duvohuu/Spider_Robot/latex/report/titlepage.tex

\begin{titlepage}   
    \begin{center}
        \vspace*{-2cm} 
        \large
        \textbf{ĐẠI HỌC QUỐC GIA THÀNH PHỐ HỒ CHÍ MINH \\
        TRƯỜNG ĐẠI HỌC BÁCH KHOA\\
        KHOA CƠ KHÍ \\}
        \vspace{0.5cm}
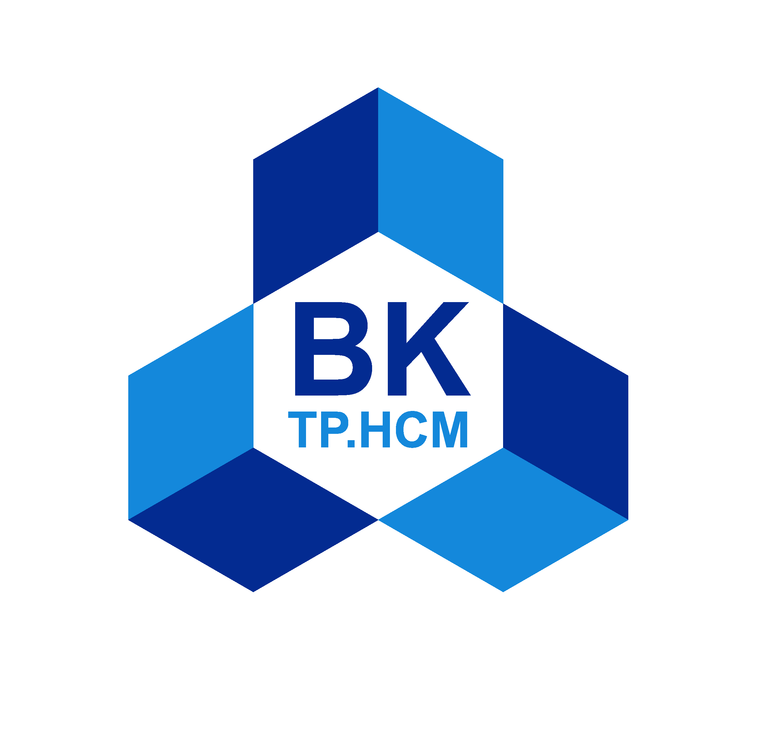
[picture p1: latex/report/pictures/hcmut.png]
         \\
        \rule{\linewidth}{0.5mm}\\
        \vspace{0.5cm}
        \Large
        \textbf{ĐỒ ÁN MÔN HỌC}\\                                                                                                                                                                                                                                                                                                                                                                                                                                                                                                                                                                                                                                                         
        \vspace{0.5cm}
        \textbf{THIẾT KẾ HỆ THỐNG CƠ ĐIỆN TỬ}\\
        \vspace{0.5cm}
        \LARGE
        \textbf{ĐỀ TÀI: THIẾT KẾ ROBOT 6 CHÂN DẠNG NHỆN} \\
        \rule{\linewidth}{0.5mm}\\
        \vspace{0.5cm}
        \large
        \textbf{LỚP L01 - HK 252} \\
        \vspace{0.5cm}
        \textbf{GVHD: Ths. Nguyễn Minh Tuấn} \\
        \begin{table}[H]
            \centering
            \large
            \textbf{Danh sách thành viên nhóm:}\\
            \vspace{0.5cm}
            \begin{tabular}{|c|c|c|}
                \hline
                \textbf{STT} & \textbf{Họ và Tên} & \textbf{MSSV} \\
                \hline
                1 & Võ Hữu Dư & 2210604\\
                \hline
                2 & Trần Quang Đạo & 2210647\\
                \hline
                3 & Nguyễn Việt Chương & 2210398\\
                \hline
                4 & Nguyễn Hoàng Thái Khang & 2211448\\
                \hline
            \end{tabular}
        \end{table}
    \end{center}        
    \vfill
    \large
    \begin{center}
        \today
    \end{center}
\end{titlepage}
