duvohuu/Spider_Robot/latex/report/main.tex

\documentclass[12pt,a4paper]{report}
\input{library}
\addbibresource{references.bib} 

%Header
\fancyhead{} % clear all header fields
\fancyhead[L]{
 \begin{tabular}{rl}
    \begin{picture}(15, 15)(0,0)
        \put(-15, -15){}
    \end{picture}&
	%\includegraphics[width=8mm, height=8mm]{hcmut.png} & %
	\begin{tabular}{l}
		\textbf{\normalsize \ttfamily Trường Đại Học Bách Khoa - ĐHQG TP.HCM}\\
		\textbf{\normalsize \ttfamily Khoa Cơ Khí}
	\end{tabular} 	
 \end{tabular}
}
\fancyhead[R]{CHƯƠNG \thechapter}

%Footer
\fancyfoot{} % clear all footer fields
\fancyfoot[L]{\normalsize \ttfamily Thiết kế hệ thống cơ điện tử}
\fancyfoot[R]{\normalsize \ttfamily Trang {\thepage}/65}
\renewcommand{\headrulewidth}{0.3pt}
\renewcommand{\footrulewidth}{0.3pt}

\begin{document}
    \include{titlepage}
    \section*{\centering LỜI CẢM ƠN}
        \hspace{0.5cm} Chúng tôi xin gửi lời cảm ơn chân thành nhất đến tất cả những người đã đóng góp và hỗ trợ trong quá trình thực hiện bài tập lớn này..\\

        Đầu tiên và quan trọng nhất, chúng tôi muốn bày tỏ lòng biết ơn sâu sắc đến PGS.TS. Nguyễn Đình Huy về sự hỗ trợ và sự hướng dẫn không ngừng nghỉ của họ. Sự kiên nhẫn, sự chia sẻ kiến thức của thầy đã là nguồn động viên lớn lao giúp chúng tôi vượt qua những thách thức trong quá trình này.\\

        Chúng tôi cũng muốn bày tỏ lòng biết ơn đến các thành viên trong nhóm cũng như bạn bè về sự hợp tác và cống hiến của họ. Sự đoàn kết và sự cống hiến từ mỗi thành viên đã góp phần tạo ra một dự án hoàn chỉnh và chất lượng.\\

        Cuối cùng, chúng tôi muốn gửi lời cảm ơn chân thành nhất đến tất cả những người sẽ lắng nghe và đánh giá bài báo cáo của chúng tôi. Sự quan tâm và hỗ trợ từ bạn đã là động lực mạnh mẽ để chúng tôi hoàn thiện công việc của mình.\\
        
        Một lần nữa, chân thành cảm ơn sâu sắc từ chúng tôi đến tất cả những người đã đóng góp vào dự án này. Sự hỗ trợ và lòng tận tụy của mọi người đã làm cho dự án này trở thành hiện thực.\\
    \tableofcontents
    \listoftables
    \listoffigures
    \newpage
    \normalsize
    \include{chapter1}
    \include{chapter2}
    \include{chapter3}
    \include{chapter4}
    \include{chapter5}
    \include{chapter6}
    \include{chapter7}
    \nocite{*}
    \printbibliography[title={TÀI LIỆU THAM KHẢO}, heading=bibintoc]
\end{document}
