duvohuu/Spider_Robot/latex/slides/chapter1.tex

% ============================================================
% CHƯƠNG 1: NHẬN BIẾT NHU CẦU
% ============================================================
\section{Nhận Biết Nhu Cầu}

% ---- Slide 1.1: Bối cảnh + Nhu cầu ----
\begin{frame}{Bối Cảnh Và Nhu Cầu Thực Tiễn}
  \begin{columns}[T]
    \column{0.52\textwidth}
      \textbf{Robot di động truyền thống:}
      \begin{itemize}
        \item Bánh xe / dải xích -- hạn chế trên địa hình gồ ghề
        \item Kém linh hoạt trong không gian chật hẹp
      \end{itemize}
      \vspace{0.2cm}
      \textbf{Nhu cầu thực tiễn cần đáp ứng:}
      \begin{itemize}
        \item \textbf{Đa địa hình:} Mỗi chân điều chỉnh độc lập
        \item \textbf{Ổn định:} Tripod gait -- luôn $\geq 3$ chân tiếp đất
        \item \textbf{Realtime:} IK + đồng bộ 18 servo
        \item \textbf{Chi phí:} Servo MG996R, ESP32, in 3D
        \item \textbf{Giáo dục:} Nền tảng nghiên cứu cơ điện tử
      \end{itemize}
    \column{0.45\textwidth}
      \centering
      
      \\\small\textit{Robot nhện 6 chân của nhóm}
  \end{columns}
\end{frame}

% ---- Slide 1.3: Lý do chọn đề tài ----
\begin{frame}{Lý Do Chọn Đề Tài}
  \begin{block}{\centering Thiết kế và chế tạo robot nhện 6 chân}
    \centering Đề tài tích hợp điển hình của ngành Cơ Điện Tử
  \end{block}
  \vspace{0.2cm}
  \begin{columns}[T]
    \column{0.48\textwidth}
      \begin{exampleblock}{Tính hội tụ kiến thức}
        Cơ khí $+$ Điện tử $+$ Lập trình nhúng $+$ Truyền thông không dây
      \end{exampleblock}
      \vspace{0.15cm}
      \begin{exampleblock}{Tính thực tiễn cao}
        Quân sự, cứu nạn, kiểm tra đường ống, thám hiểm không gian
      \end{exampleblock}
    \column{0.48\textwidth}
      \begin{exampleblock}{Khả năng thực thi}
        Máy in 3D, linh kiện phổ biến -- hoàn thành trong 1 học kỳ
      \end{exampleblock}
      \vspace{0.15cm}
      \begin{exampleblock}{Giá trị học thuật}
        Tối ưu cấu hình chân, thuật toán dáng đi, mạch điều khiển phân tán
      \end{exampleblock}
  \end{columns}
\end{frame}
