duvohuu/Spider_Robot/latex/slides/chapter6.tex

% ============================================================
% CHƯƠNG 6: THIẾT KẾ CHI TIẾT
% ============================================================
\section{Thiết Kế Chi Tiết}

% ---- Slide 6.1: Chi tiết cơ khí ----
\begin{frame}{Thiết Kế Chi Tiết Cơ Khí}
  \begin{columns}[T]
    \column{0.22\textwidth}
      \centering
      
      \\\small\textit{Thân robot}
    \column{0.22\textwidth}
      \centering
      
      \\\small\textit{Khớp Coxa}
    \column{0.22\textwidth}
      \centering
      
      \\\small\textit{Khớp Femur}
    \column{0.22\textwidth}
      \centering
      
      \\\small\textit{Khớp Tibia}
  \end{columns}
  \vspace{0.3cm}
  \begin{columns}[T]
    \column{0.48\textwidth}
      \textbf{Thông số chân:} L1--L2--L3 = 168--120--60 mm
    \column{0.48\textwidth}
      \textbf{Vật liệu:} Nhựa PLA in 3D FDM
  \end{columns}
\end{frame}

% ---- Slide 6.2: Tính toán lựa chọn servo ----
\begin{frame}{Tính Toán Lựa Chọn Servo}
  \begin{columns}[T]
    \column{0.48\textwidth}
      \centering
      
      \\\small\textit{Mô hình tải trọng -- 3 chân tiếp đất}
    \column{0.50\textwidth}
      \small
      \textbf{Phản lực (3 chân đỡ):}
      $N_3 = W/3 = 19.62/3 \approx 6.54\;\text{N}$

      \vspace{0.15cm}
      \textbf{Mômen khớp Femur (lớn nhất):}
      $T_h = N_3 (L_1{+}L_2{+}L_3) \approx 23.2\;\text{kgf.cm}$

      \vspace{0.15cm}
      \textbf{Mômen yêu cầu ($K{=}1.3$):}
      $T_\text{cần} = 1.3 \times 23.2 \approx 30.2\;\text{kgf.cm}$

      \vspace{0.15cm}
      \begin{alertblock}{Chọn Servo DS3218}
        \small Moment max $\approx 20$--25 kgf.cm tại 6V\\
        Kết hợp bố trí cơ khí tối ưu
      \end{alertblock}
  \end{columns}
\end{frame}

% ---- Slide 6.3: ANSYS kết quả ----
\begin{frame}{Phân Tích Lực ANSYS -- Kết Quả}
  \begin{columns}[T]
    \column{0.32\textwidth}
      \centering
      
      \\\small\textit{\textbf{Ứng suất} von Mises}
    \column{0.32\textwidth}
      \centering
      
      \\\small\textit{\textbf{Chuyển vị} -- max 2.38 mm}
    \column{0.32\textwidth}
      \centering
      
      \\\small\textit{\textbf{Biến dạng} -- $\varepsilon_\mathrm{max}=3.19{\times}10^{-3}$}
  \end{columns}
\end{frame}

% ---- Slide 6.4: Mạch điện PCB ----
\begin{frame}{Thiết Kế Chi Tiết Mạch Điện}
  \begin{columns}[T]
    \column{0.48\textwidth}
      \centering
      
      \\\small\textit{Layout mạch PCB}
      \begin{itemize}\small
        \item ESP32 + 2 $\times$ PCA9685
        \item Kết nối 18 servo
      \end{itemize}
    \column{0.48\textwidth}
      \centering
      
      \\\small\textit{Mô hình PCB 3D}
      \begin{itemize}\small
        \item Cầu chì bảo vệ nguồn
        \item DC-DC tách nguồn servo / điều khiển
      \end{itemize}
  \end{columns}
\end{frame}
