duvohuu/Spider_Robot/latex/report/pictures/ElectricalDiagram.pdf

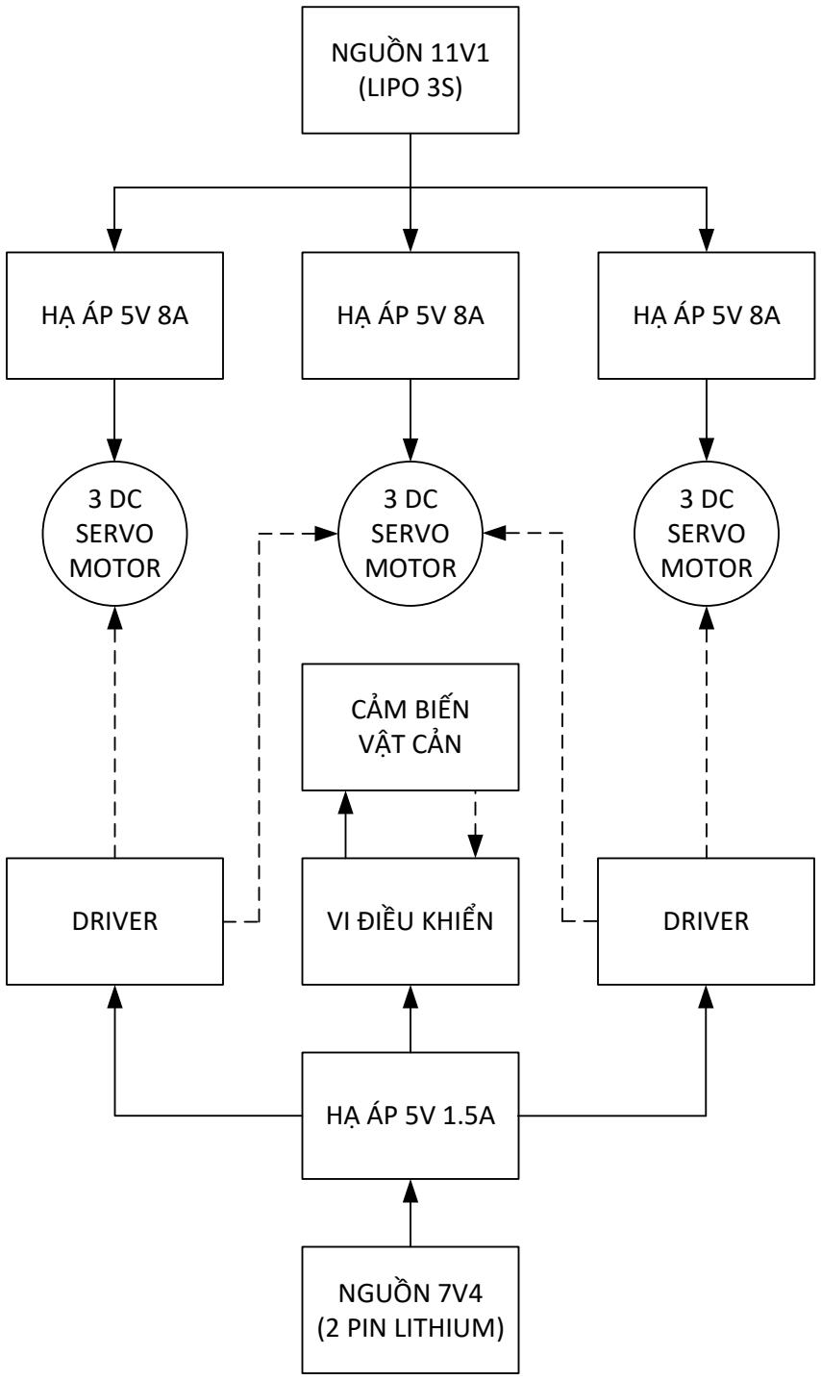
[picture p36: figure]
NGUỒN 11V1 (LIPO 3S); 3 DC SERVO MOTOR; NGUỒN 7V4 (2 PIN LITHIUM); DRIVER; VI ĐIỀU KHIỂN; CẢM BIẾN VẬT CẢN
