duvohuu/Spider_Robot/latex/slides/main.tex

\documentclass[aspectratio=169]{beamer}

% ============================================================
% Preamble: packages, theme, màu sắc, font, footer
% ============================================================
\input{library}

% ============================================================
% Thông tin bài thuyết trình
% ============================================================
\title[Robot 6 Chân Dạng Nhện]{Thiết kế Robot 6 Chân Dạng Nhện}
\subtitle{Thiết Kế Hệ Thống Cơ Điện Tử}
\author[Nhóm 05]{
  Võ Hữu Dư (2210604) \and
  Trần Quang Đạo (2210647) \and
  Nguyễn Việt Chương (2412192) \and
  Nguyễn Hoàng Thái Khang (2411202)
}
\institute[HCMUT]{
  Trường Đại Học Bách Khoa -- ĐHQG TP.HCM \\
  Khoa Cơ Khí -- Lớp L01 -- HK252
}
\date{\today}

% ============================================================
% NỘI DUNG
% ============================================================
\begin{document}

\include{titlepage}

\include{chapter1}
\include{chapter2}
\include{chapter3}
\include{chapter4}
\include{chapter5}
\include{chapter6}
\include{chapter7}

\end{document}
