duvohuu/Spider_Robot/hardware/PCB.kicad_pcb

## KiCad design hardware/PCB.kicad_pcb (2026-05-05)

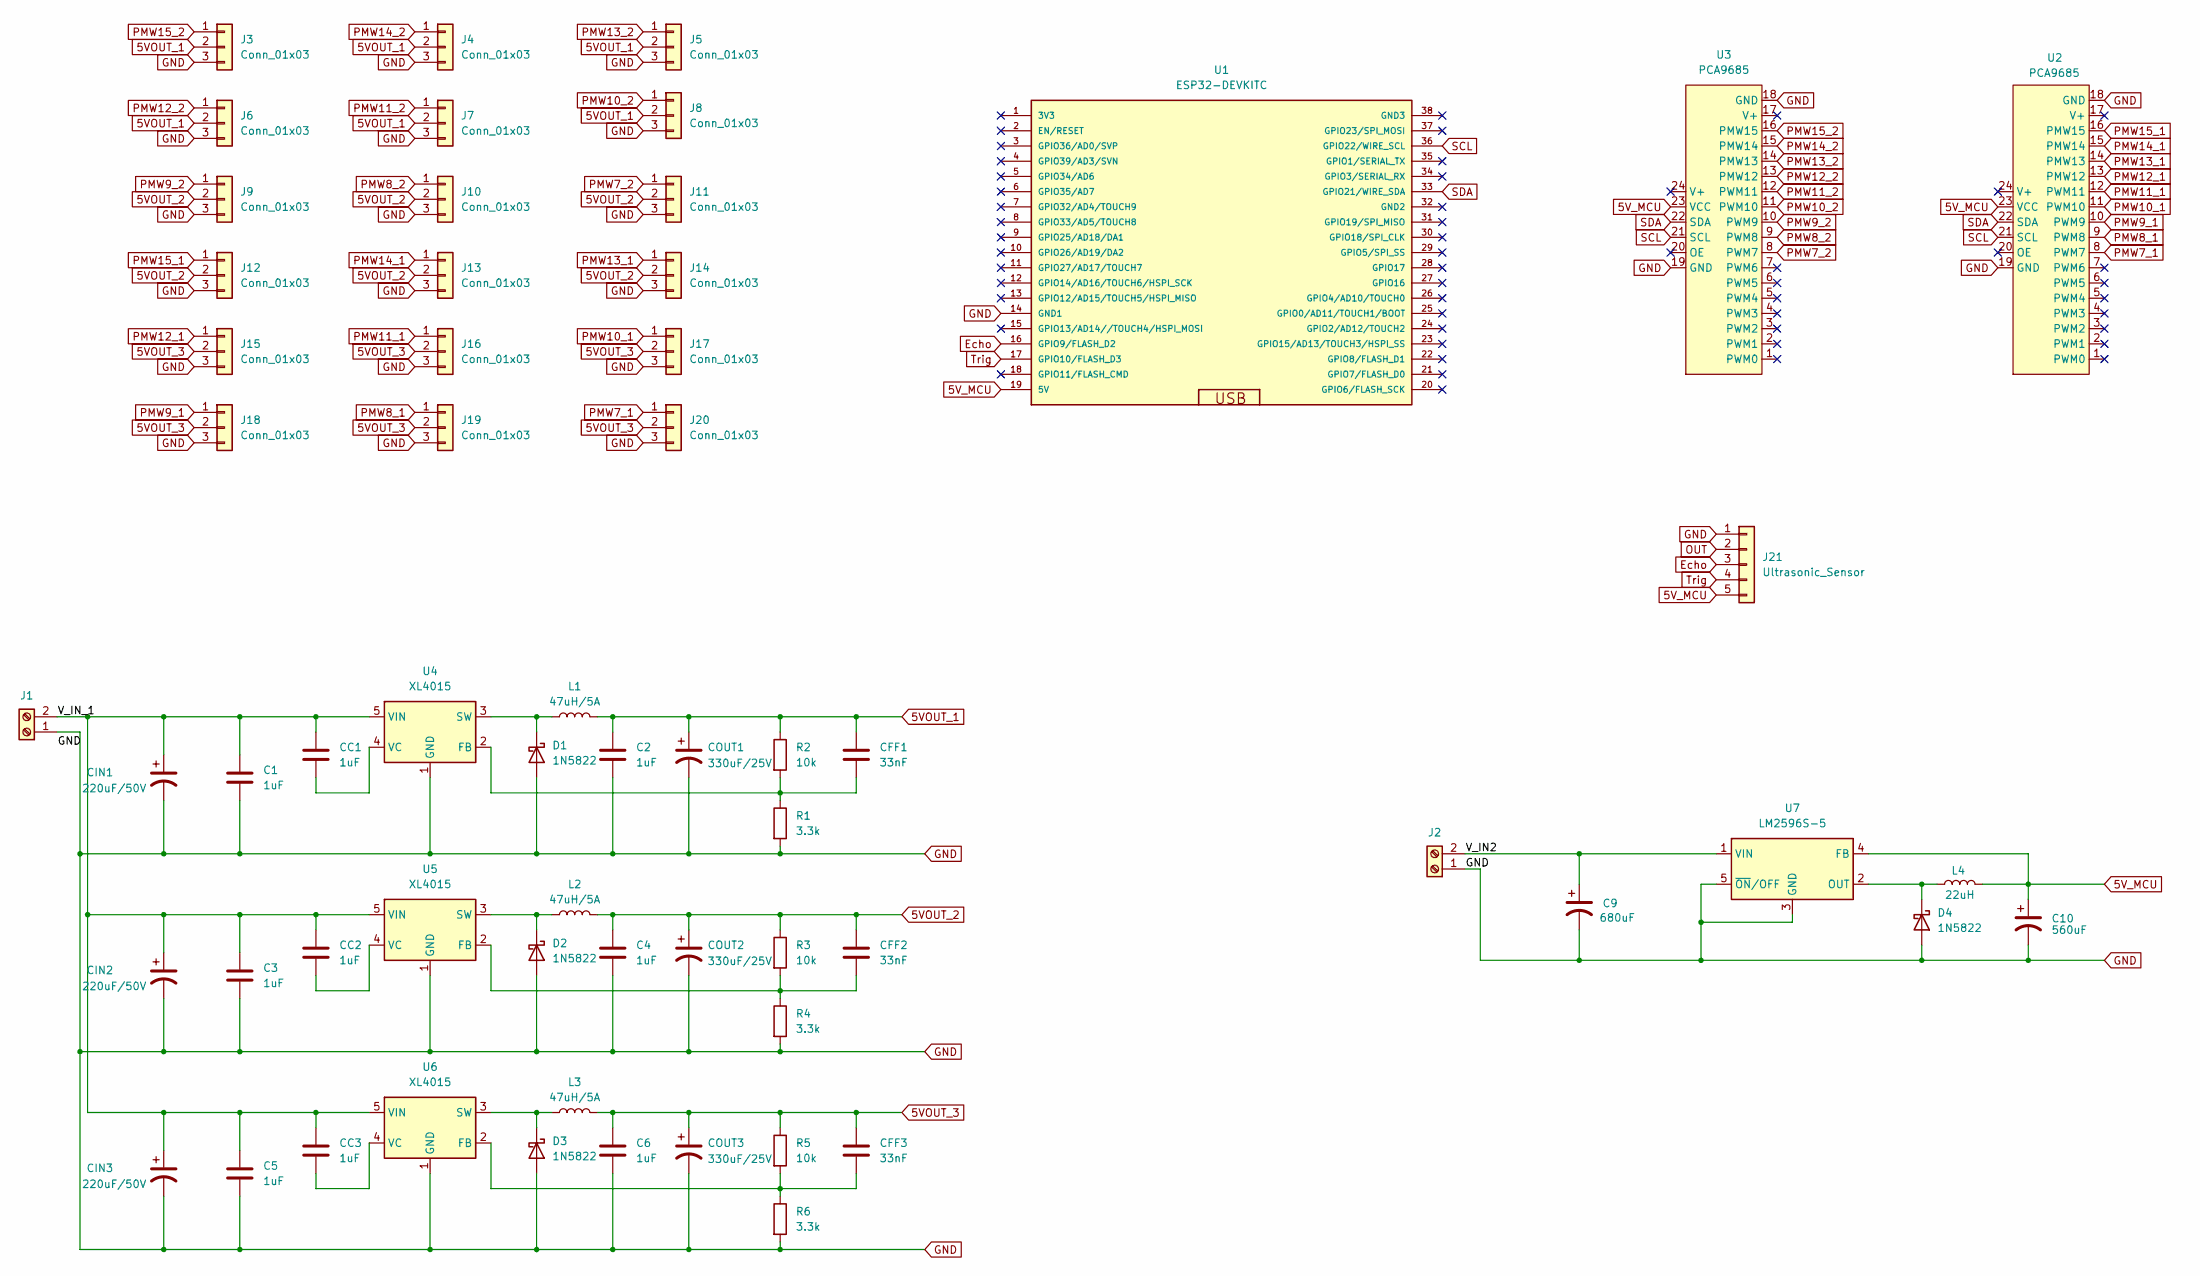
[picture p42: schematic PCB.kicad_sch]

Parts:
C1, C2, C3, C4, C5, C6: 1uF; C_0603_1608Metric_Pad1.08x0.95mm_HandSolder
C9: 680uF; CP_Radial_D8.0mm_P5.00mm
C10: 560uF; CP_Radial_D8.0mm_P5.00mm
CC1, CC2, CC3: 1uF; C_0603_1608Metric_Pad1.08x0.95mm_HandSolder
CFF1, CFF2, CFF3: 33nF; C_0603_1608Metric_Pad1.08x0.95mm_HandSolder
CIN1, CIN2, CIN3: 220uF/50V; CP_Radial_D8.0mm_P5.00mm
COUT1, COUT2, COUT3: 330uF/25V; CP_Radial_D8.0mm_P5.00mm
D1, D2, D3, D4: 1N5822; D_SMA_Handsoldering
J1, J2: MCU POWER; TerminalBlock_MaiXu_MX126-5.0-02P_1x02_P5.00mm
J3, J4, J5, J6, J7, J8, J9, J10, J11, J12, J13, J14, J15, J16, J17, J18, J19, J20: Conn_01x03; PinHeader_1x03_P2.54mm_Vertical
J21: Ultrasonic_Sensor; PinHeader_1x05_P2.54mm_Vertical
L1, L2, L3: 47uH/5A; L_12x12mm_H8mm
L4: 22uH; L_12x12mm_H8mm
R1, R4, R6: 3.3k; R_Axial_DIN0207_L6.3mm_D2.5mm_P7.62mm_Horizontal
R2, R3, R5: 10k; R_Axial_DIN0207_L6.3mm_D2.5mm_P7.62mm_Horizontal
U1: ESP32-DEVKITC
U2, U3: PCA9685
U4, U5, U6: XL4015; TO-263-5_TabPin3
U7: LM2596S-5; TO-263-5_TabPin3

Connections:
5VOUT_1: C2.1, CFF1.1, COUT1.1, J3.2, J4.2, J5.2, J6.2, J7.2, J8.2, L1.2, R2.1
5VOUT_2: C4.1, CFF2.1, COUT2.1, J9.2, J10.2, J11.2, J12.2, J13.2, J14.2, L2.2, R3.1
5VOUT_3: C6.1, CFF3.1, COUT3.1, J15.2, J16.2, J17.2, J18.2, J19.2, J20.2, L3.2, R5.1
5V_MCU: C10.1, J21.5, L4.2, U1.19 (5V), U2.23 (VCC), U3.23 (VCC), U7.4 (FB)
/V_IN2: C9.1, J2.2, U7.1 (VIN)
/V_IN_1: C1.1, C3.1, C5.1, CC1.1, CC2.1, CC3.1, CIN1.1, CIN2.1, CIN3.1, J1.2, U4.5 (VIN), U5.5 (VIN), U6.5 (VIN)
Echo: J21.3, U1.16 (GPIO9/FLASH_D2)
GND: C1.2, C2.2, C3.2, C4.2, C5.2, C6.2, C9.2, C10.2, CIN1.2, CIN2.2, CIN3.2, COUT1.2, COUT2.2, COUT3.2, D1.2 (A), D2.2 (A), D3.2 (A), D4.2 (A), J1.1, J2.1, J3.3, J4.3, J5.3, J6.3, J7.3, J8.3, J9.3, J10.3, J11.3, J12.3, J13.3, J14.3, J15.3, J16.3, J17.3, J18.3, J19.3, J20.3, J21.1, R1.2, R4.2, R6.2, U1.14 (GND1), U2.18 (GND), U2.19 (GND), U3.18 (GND), U3.19 (GND), U4.1 (GND), U5.1 (GND), U6.1 (GND), U7.3 (GND), U7.5 (~ON/OFF)
unnamed: D1.1 (K), L1.1, U4.3 (SW)
unnamed: D2.1 (K), L2.1, U5.3 (SW)
unnamed: D3.1 (K), L3.1, U6.3 (SW)
unnamed: D4.1 (K), L4.1, U7.2 (OUT)
unnamed: CFF1.2, R1.1, R2.2, U4.2 (FB)
unnamed: CC1.2, U4.4 (VC)
unnamed: CFF2.2, R3.2, R4.1, U5.2 (FB)
unnamed: CC2.2, U5.4 (VC)
unnamed: CFF3.2, R5.2, R6.1, U6.2 (FB)
unnamed: CC3.2, U6.4 (VC)
OUT: J21.2
PMW7_1: J20.1, U2.8 (PWM7)
PMW7_2: J11.1, U3.8 (PWM7)
PMW8_1: J19.1, U2.9 (PWM8)
PMW8_2: J10.1, U3.9 (PWM8)
PMW9_1: J18.1, U2.10 (PWM9)
PMW9_2: J9.1, U3.10 (PWM9)
PMW10_1: J17.1, U2.11 (PWM10)
PMW10_2: J8.1, U3.11 (PWM10)
PMW11_1: J16.1, U2.12 (PWM11)
PMW11_2: J7.1, U3.12 (PWM11)
PMW12_1: J15.1, U2.13 (PMW12)
PMW12_2: J6.1, U3.13 (PMW12)
PMW13_1: J14.1, U2.14 (PMW13)
PMW13_2: J5.1, U3.14 (PMW13)
PMW14_1: J13.1, U2.15 (PMW14)
PMW14_2: J4.1, U3.15 (PMW14)
PMW15_1: J12.1, U2.16 (PMW15)
PMW15_2: J3.1, U3.16 (PMW15)
SCL: U1.36 (GPIO22/WIRE_SCL), U2.21 (SCL), U3.21 (SCL)
SDA: U1.33 (GPIO21/WIRE_SDA), U2.22 (SDA), U3.22 (SDA)
Trig: J21.4, U1.17 (GPIO10/FLASH_D3)

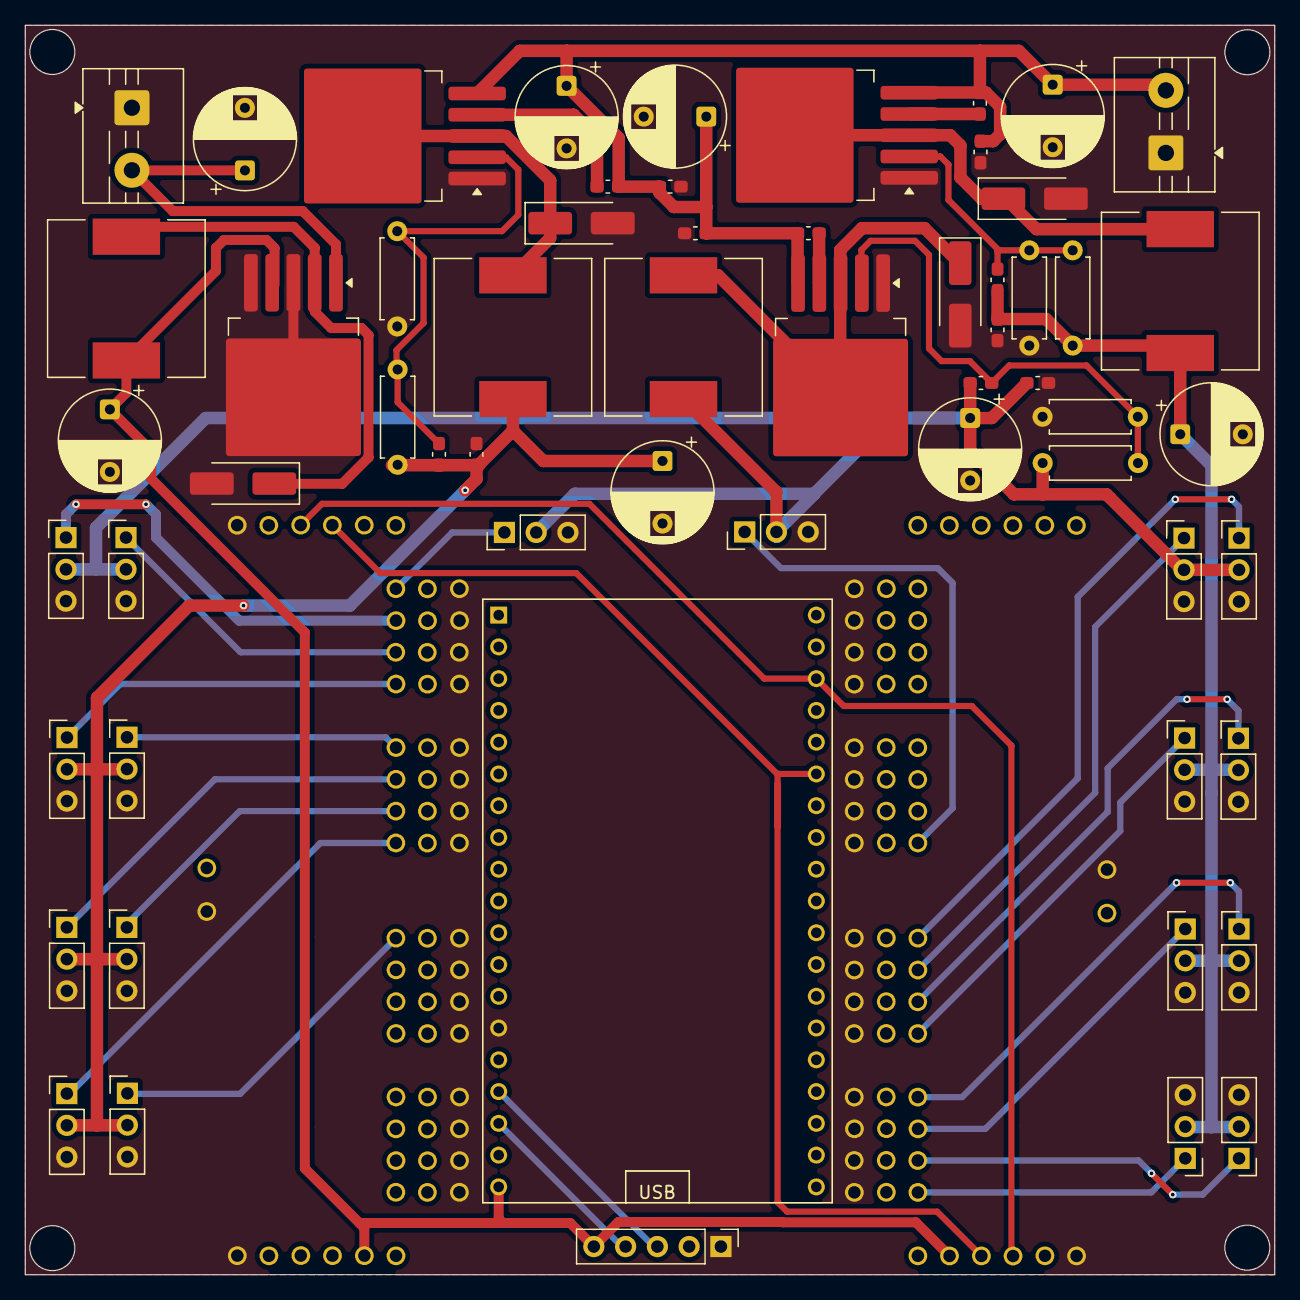
[picture p43: board PCB.kicad_pcb from above]

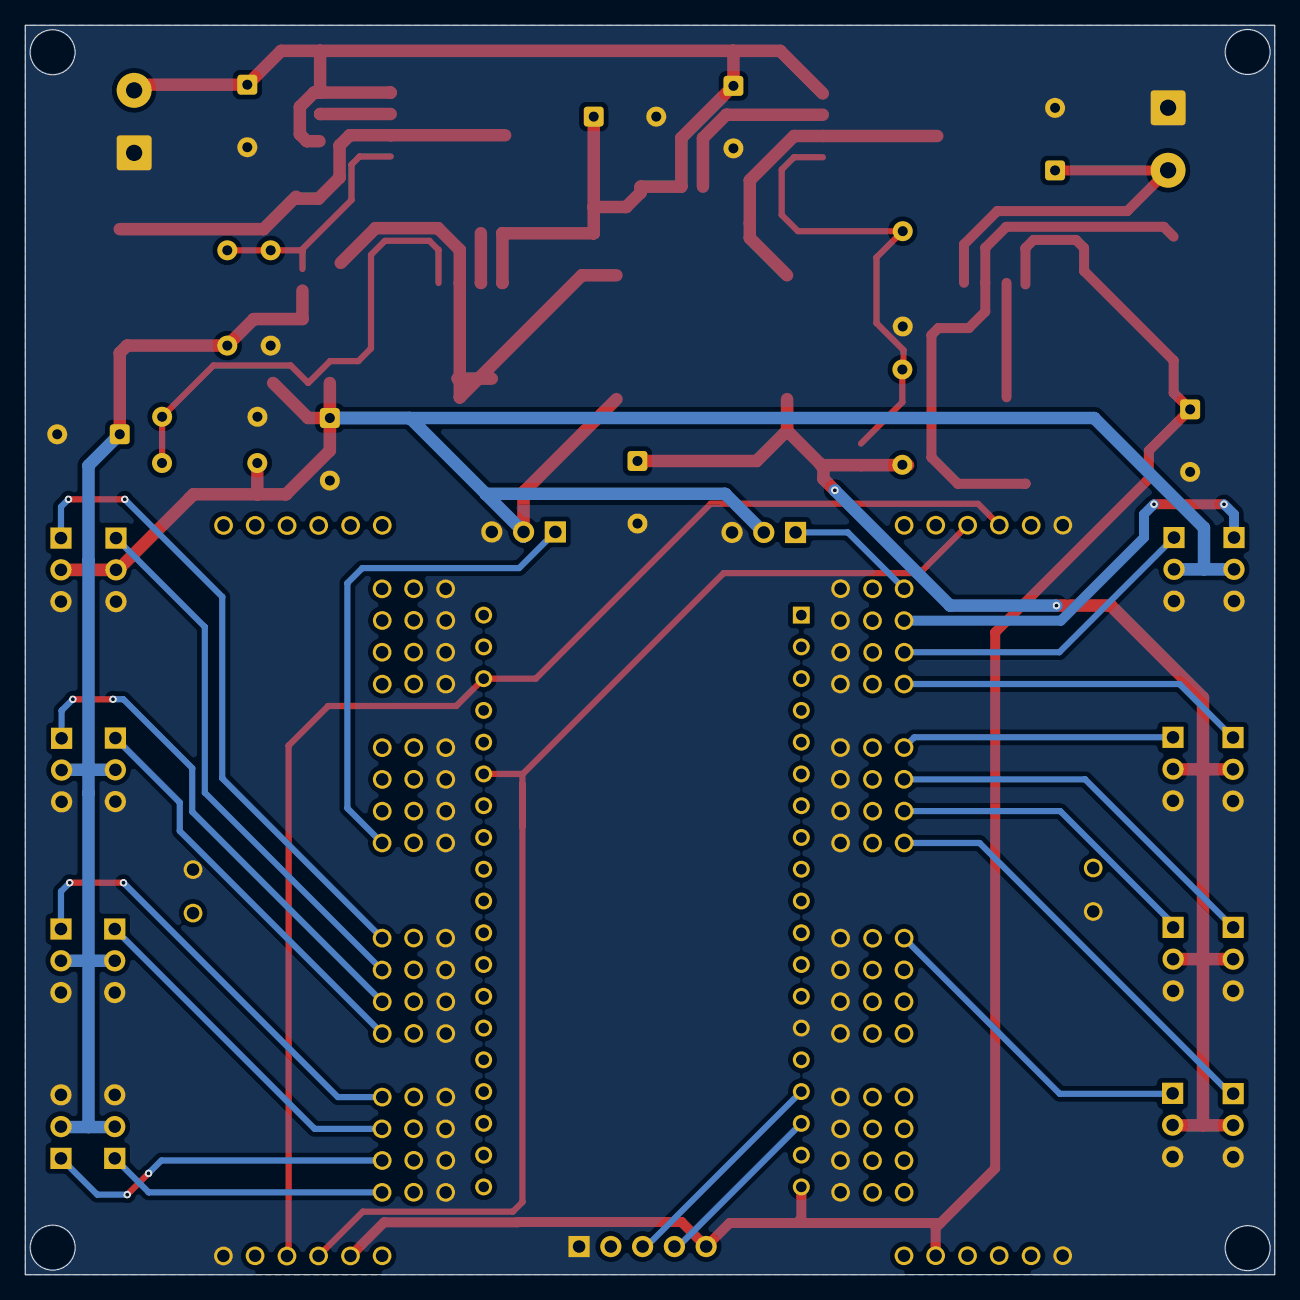
[picture p44: board PCB.kicad_pcb from below]

Board: 2 copper layers, 99.9 x 99.9 mm, 62 parts (2 on the bottom side), 39 nets.
