duvohuu/Spider_Robot/(commit log)

2026-03-12 Init Project
    [PCB.kicad_pcb, PCB.kicad_sch]
2026-03-30 Update code folder
    [PCB.csv, PCB.kicad_pcb, PCB.kicad_sch]
2026-04-24 Update Hardware PCB
    [PCB.csv, PCB.kicad_pcb, PCB.kicad_sch]
2026-05-05 Add latex template and stand mode for robot
    [PCB.kicad_pcb]
2026-05-05 Add inverse kinematic of robot
